chithigun23/ANUFS-BSPD-2026/docs/bspd-architecture.html

# ANUFS / BSPD 2026

Analog safety architecture · two fault paths, one latched shutdown

⏸ pause

### Sense + decide

- • TPS = throttle position; BPS = brake pressure.
- • Three independent sensor windows detect out-of-range inputs.
- • U1 detects hard braking with either throttle channel above 10%.

### Qualify + remember

- • Sensor faults: approximately 100 ms.
- • Brake/throttle overlap: approximately 1 second.
- • A sustained fault clears U5 Q; recovery alone does not re-enable.

### Power + reset

- • U6 regulates +12 V to +5 V for the logic.
- • U7 with R32/C19/C20 generates the power-on preset.
- • U5 drives Q1/Q2 and the latch LED; SC_OUT feeds the external shutdown circuit.

Connectivity: supplied KiCad netlist, 15 Sep 2026. Timing: schematic intent. Moving dots show logical propagation, not timing or current. Power, reference and indicator wiring summarized in the cards.
