chithigun23/ANUFS-BSPD-2026/BSPD_DigiKey_BOM.xlsx

Sheet: BOM
# | Reference(s) | Qty | Value | Package / Footprint | Manufacturer | Manufacturer Part Number (MPN) | DigiKey Part Number | Purchasing spec / action | Notes
1 | C1,C19,C20 | 3 | 4.7uF | C_0805_2012Metric_Pad1.18x1.45mm_HandSolder |  |  |  | Voltage: 16V; Dielectric: X7R; Tolerance: 10%; Existing BOM: TIMING CAP - X7R, 25V or 50V rating (NOT 6.3/10V); Select exact supplier part matching value and footprint. | Sets BSP-02 startup delay (C19||C20) and the 1 s trip timer (C1). Low-voltage-rated X7R loses 30-50% capacitance under 5 V DC bias, which shifts both timings. Order 25 V+ to minimise derating, then measure.
2 | C2-C7 | 6 | 1uF | C_0805_2012Metric_Pad1.18x1.45mm_HandSolder |  |  |  | Voltage: 16V; Dielectric: X7R; Tolerance: 10%; Existing BOM: X7R, 16V+; Select exact supplier part matching value and footprint. | Comparator input filters.
3 | C8-C14,C17,C18,C21-C28 | 17 | 100nF | C_0805_2012Metric_Pad1.18x1.45mm_HandSolder |  |  |  | Voltage: 16V; Dielectric: X7R; Tolerance: 10%; Existing BOM: X7R, 25V/50V; Select exact supplier part matching value and footprint. | Decoupling. Any reputable 0805 X7R.
4 | C15 | 1 | 10uF | C_0805_2012Metric_Pad1.18x1.45mm_HandSolder |  |  |  | Schematic: 25V, X7R, 10%. Select matching 0805 supplier part. | Input capacitor. Existing BOM specifies at least 25V.
5 | C16 | 1 | 10uF | C_0805_2012Metric_Pad1.18x1.45mm_HandSolder |  |  |  | Schematic: 16V, X7R, 10%. Resolve output-capacitor ESR requirement before ordering. | Existing BOM flags LM1117 output capacitor ESR. See Cautions.
6 | D1,D6 | 2 | 1N4148W | D_SOD-123 | Diodes Incorporated | 1N4148W-7-F |  | Match package and ordering suffix. | MPN inferred from value - verify before ordering.
7 | D2-D4 | 3 | AQ1005-01ETG | D_SOD-882 | Littelfuse | AQ1005-01ETG |  | Match package and ordering suffix.
8 | D5 | 1 | SMBJ16A | SMBJ16A | Littelfuse | SMBJ16A |  | Match package and ordering suffix. | LCSC: C151254
9 | D7,D8 | 2 | S1B-13-F | S1B-13-F | Diodes Incorporated | S1B-13-F |  | Match package and ordering suffix. | LCSC: C156295
10 | D9-D15 | 7 | AP2012EC | AP2012EC | Kingbright | AP2012EC |  | Match package and ordering suffix.
11 | J1 | 1 | Conn_02x04_Counter_Clockwise | WirePad_2x04_P3.0mm |  |  |  | No part to buy | Bare through-hole wire pads - solder wires directly. Bare wire pads.
12 | Q1 | 1 | AO3400A | SOT-23 | Alpha & Omega | AO3400A |  | Match package and ordering suffix. | MPN inferred from value - verify before ordering.
13 | Q2 | 1 | AO3401A | SOT-23 | Alpha & Omega | AO3401A |  | Match package and ordering suffix. | MPN inferred from value - verify before ordering.
14 | R1,R10,R15,R25 | 4 | 5.49k | R_0805_2012Metric_Pad1.20x1.40mm_HandSolder |  |  |  | Tolerance: 1%; Existing BOM: 0805, 1% (E96 value); Select exact supplier part matching value and footprint.
15 | R2,R4,R5,R9,R13,R17,R24 | 7 | 5.1k | R_0805_2012Metric_Pad1.20x1.40mm_HandSolder |  |  |  | Tolerance: 1%; Existing BOM: 0805, 1% (E96 value); Select exact supplier part matching value and footprint.
16 | R3,R6-R8,R11,R12,R14,R16,R18,R19,R22,R27,R32,R33 | 14 | 150k | R_0805_2012Metric_Pad1.20x1.40mm_HandSolder |  |  |  | Tolerance: 1%; Existing BOM: 0805, 1% (E96 value); Select exact supplier part matching value and footprint.
17 | R20,R30 | 2 | 54.9k | R_0805_2012Metric_Pad1.20x1.40mm_HandSolder |  |  |  | Tolerance: 1%; Existing BOM: 0805, 1% (E96 value); Select exact supplier part matching value and footprint.
18 | R21 | 1 | 21.5k | R_0805_2012Metric_Pad1.20x1.40mm_HandSolder |  |  |  | Tolerance: 1%; Existing BOM: 0805, 1% (E96 value); Select exact supplier part matching value and footprint.
19 | R23 | 1 | 2.61k | R_0805_2012Metric_Pad1.20x1.40mm_HandSolder |  |  |  | Tolerance: 1%; Existing BOM: 0805, 1% (E96 value); Select exact supplier part matching value and footprint.
20 | R26 | 1 | 7.15k | R_0805_2012Metric_Pad1.20x1.40mm_HandSolder |  |  |  | Tolerance: 1%; Existing BOM: 0805, 1% (E96 value); Select exact supplier part matching value and footprint.
21 | R28,R29 | 2 | 49.9k | R_0805_2012Metric_Pad1.20x1.40mm_HandSolder |  |  |  | Tolerance: 1%; Existing BOM: 0805, 1% (E96 value); Select exact supplier part matching value and footprint.
22 | R31,R39-R45 | 8 | 500 | R_0805_2012Metric_Pad1.20x1.40mm_HandSolder |  |  |  | Tolerance: 1%; Existing BOM: ORDER 499 ohm (E96 1%) or 510 ohm (E24 5%); Select exact supplier part matching value and footprint. | "500 ohm" is not a standard 1% value. These are LED series resistors (R39-R45) and R31 gate resistor - exact value is not critical.
23 | R34-R38 | 5 | 10M | R_0805_2012Metric_Pad1.20x1.40mm_HandSolder |  |  |  | Tolerance: 1%; Existing BOM: 1% - high value, check availability; Select exact supplier part matching value and footprint. | Threshold-node bleed resistors.
24 | R46 | 1 | 0 | R_0805_2012Metric_Pad1.20x1.40mm_HandSolder |  |  |  | Select exact supplier part matching value and footprint.
25 | RV1-RV5 | 5 | 3313J-1-203E | 3313J-1-103E | Bourns | 3313J-1-203E |  | Tolerance: 20%; Resistance: 20k | LCSC: C124621
26 | SW1,SW2 | 2 | CJS-1200TB1 | CJS-1200TB1 | Nidec Components | CJS-1200TB1 |  | Match package and ordering suffix. | LCSC: C2921631
27 | TP1 | 1 | TPS1 | TestPoint_Keystone_5000-5004_Miniature |  |  |  | Existing BOM: Optional - only if you want physical test pins; Optional physical test point; select matching footprint. | Keystone 5000-5004 miniature test point. Board works without them (bare pad).
28 | TP2 | 1 | TPS2 | TestPoint_Keystone_5000-5004_Miniature |  |  |  | Existing BOM: Optional - only if you want physical test pins; Optional physical test point; select matching footprint. | Keystone 5000-5004 miniature test point. Board works without them (bare pad).
29 | TP3 | 1 | BPS | TestPoint_Keystone_5000-5004_Miniature |  |  |  | Existing BOM: Optional - only if you want physical test pins; Optional physical test point; select matching footprint. | Keystone 5000-5004 miniature test point. Board works without them (bare pad).
30 | TP4 | 1 | +0V45 | TestPoint_Keystone_5000-5004_Miniature |  |  |  | Existing BOM: Optional - only if you want physical test pins; Optional physical test point; select matching footprint. | Keystone 5000-5004 miniature test point. Board works without them (bare pad).
31 | TP5 | 1 | +1V25 | TestPoint_Keystone_5000-5004_Miniature |  |  |  | Existing BOM: Optional - only if you want physical test pins; Optional physical test point; select matching footprint. | Keystone 5000-5004 miniature test point. Board works without them (bare pad).
32 | TP6 | 1 | +2V5 | TestPoint_Keystone_5000-5004_Miniature |  |  |  | Existing BOM: Optional - only if you want physical test pins; Optional physical test point; select matching footprint. | Keystone 5000-5004 miniature test point. Board works without them (bare pad).
33 | TP7 | 1 | +4V5 | TestPoint_Keystone_5000-5004_Miniature |  |  |  | Existing BOM: Optional - only if you want physical test pins; Optional physical test point; select matching footprint. | Keystone 5000-5004 miniature test point. Board works without them (bare pad).
34 | U1-U4 | 4 | TLV1704AIPWR | TLV1704 | Texas Instruments | TLV1704AIPWR |  | Match package and ordering suffix.
35 | U5 | 1 | SN74HC74DR | SN74HC74DR | Texas Instruments | SN74HC74DR |  | Match package and ordering suffix. | LCSC: C6762
36 | U6 | 1 | LM1117MP-5.0 | SOT-223-3_TabPin2 | Texas Instruments | LM1117MP-5.0/NOPB |  | Match package and ordering suffix. | MPN inferred from value - verify before ordering.
37 | U7 | 1 | SN74LVC2G14DBVR | SN74LVC2G14DBVR | Texas Instruments | SN74LVC2G14DBVR |  | Match package and ordering suffix. | LCSC: C12401
38 | U8,U9 | 2 | SN74LVC3G14DCUR | SN74LVC3G14DCUR | Texas Instruments | SN74LVC3G14DCUR |  | Match package and ordering suffix. | LCSC: C98856
 | TOTAL PLACEMENTS | 115

Sheet: Cautions
Item | Severity | What it is | What to do before / when ordering
BSP-04 C16 regulator output cap | HIGH | U6 (LM1117MP-5.0) output capacitor C16 is a generic 10uF in an 0805 footprint. TI's datasheet states the output cap ESR must be 0.3-22 ohm and specifies 10uF minimum IF A TANTALUM IS USED. A standard 0805 X5R/X7R MLCC has roughly 0.005 ohm ESR - 60x below TI's minimum - so the loop can oscillate. | The 0805 pads are the HandSolder type (elongated), so a 1206/3216 tantalum can usually be tacked across them. Order BOTH: a 10uF 25V X7R 0805 (default fit) AND a 10uF 16V tantalum (e.g. Kemet T491A/AVX TAJ A-case) as the fallback. At bring-up, scope the 5 V rail for oscillation; if it rings, fit the tantalum.
BSP-08 TVS vs regulator rating | HIGH | D5 is an SMBJ16A (16 V standoff) feeding U6 directly. Verified from TI's datasheet: LM1117 absolute max VIN = 20 V, recommended max = 15 V. The SMBJ16A clamps to 26.0 V at its full rated 23.1 A pulse - above the regulator's absolute maximum. Protection coordination is unproven for a large surge. | No board change possible at this revision. Mitigate off-board: make sure there is real series impedance upstream (fuse + harness length) so the TVS never has to clamp at full rated current at the regulator's pins. Treat 'survives supply transients' as a bench item. For v2, consider a 40 V-capable regulator.
Timing-cap DC bias (affects BSP-02 / BSP-05) | MEDIUM | C1 sets the ~1 s trip timer (R7+R8 = 300k into C1 = 4.7uF -> 0.977 s) and C19||C20 = 9.4uF sets the startup preset delay with R32 = 150k. Class-II ceramics (X5R/X7R) lose large amounts of capacitance under DC bias - a 6.3 V or 10 V rated 4.7uF 0805 can drop 30-50% at 5 V, shortening BOTH timings. | Order the 4.7uF parts at 25 V or 50 V rating in 0805 - higher voltage rating means far less derating at 5 V. Then measure both timings on the bench (BSP-05 already accepts the margin, so the measurement is the closing evidence).
R31, R39-R45 '500 ohm' | LOW | The schematic value is 500 ohm, which is not a standard E96 (1%) or E24 (5%) value. | Order 499 ohm (E96 1%) or 510 ohm (E24 5%). These are LED series resistors and one gate resistor - the exact value is not critical.
TP7 silkscreen label | LOW (cosmetic, but permanent) | TP7 connects to net +4V7 (the divider produces ~4.75 V) but its silkscreen label reads '+4V5'. Once the PCB is fabricated this is permanent. | If you have not sent the PCB yet, change TP7's value/label to +4V7. Otherwise just note it - the test point is electrically correct, only the label is wrong.
Silkscreen text height | LOW (cosmetic) | Seven silkscreen labels (BPS, FLT, TP1, HB, TPx10, LATCH, TP2) are 0.9 mm; JLCPCB's stated minimum legible silk text height is 1.0 mm. | JLCPCB will still print them, just less crisply. Bump to 1.0 mm if you are doing another layout pass anyway.
BSP-03 Threshold calibration | OPEN - not a board change | The adjustable thresholds (RV1-RV5, SW1/SW2) cannot be set correctly without measured sensor characteristics from the actual car. | Confirm the throttle-body and brake-pressure sensor part numbers, measure their endpoints, then set and secure the trimmers. This is commissioning work, not a fab blocker.
BSP-01 Sensor-loss timing | OPEN - engineering note only | Retained as an engineering note; the review records no mandatory PCB change. | Optional characterisation if your validation plan includes the sensor-loss case.
Supplier selection | TO COMPLETE | Rows without an exact MPN require part selection. | Use the value, footprint and listed specifications. Blank DigiKey numbers have not been sourced.
DigiKey Upload | SCOPE | Only explicit schematic MPNs and non-inferred existing BOM MPNs are included. | Resolve rows with missing or inferred part numbers on the BOM before adding them to an order.
Quantity basis | INFO | 115 BOM-included board items; one board. | Excludes: G***, G***, G***, H1, H2, H3, H4. Optional test points and bare wire pads may not require purchased parts.
Source | INFO | Current bspd.kicad_pcb and matching schematic, 2026-09-15. | Quantities and footprints use the PCB. Part metadata uses the schematic.
Capacitor voltage specifications | CHECK | The schematic uses 16V for timing/decoupling capacitors; the existing BOM recommends higher ratings. | Both source specifications are retained on the BOM. Resolve the purchasing rating before ordering.

Sheet: DigiKey Upload
Manufacturer Part Number | Quantity | Customer Reference
AQ1005-01ETG | 3 | D2-D4
SMBJ16A | 1 | D5
S1B-13-F | 2 | D7,D8
AP2012EC | 7 | D9-D15
3313J-1-203E | 5 | RV1-RV5
CJS-1200TB1 | 2 | SW1,SW2
TLV1704AIPWR | 4 | U1-U4
SN74HC74DR | 1 | U5
SN74LVC2G14DBVR | 1 | U7
SN74LVC3G14DCUR | 2 | U8,U9
Only source-specified MPNs are listed. Complete missing or inferred part numbers on the BOM before ordering.
