chithigun23/ANUFS-BSPD-2026/bspd-kicad/bspd-library/3d/SN74AHC14DBR.step

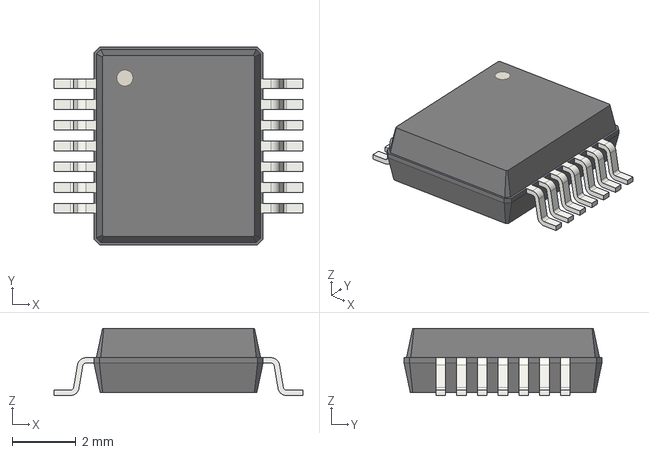
[picture p1: CAD file, 2026-09-29]
bspd-kicad/bspd-library/3d/SN74AHC14DBR.step
7.80 x 6.20 x 2.10 mm
