chithigun23/ANUFS-BSPD-2026/bspd-kicad/bspd-library/3d/3313J-1-203E.step

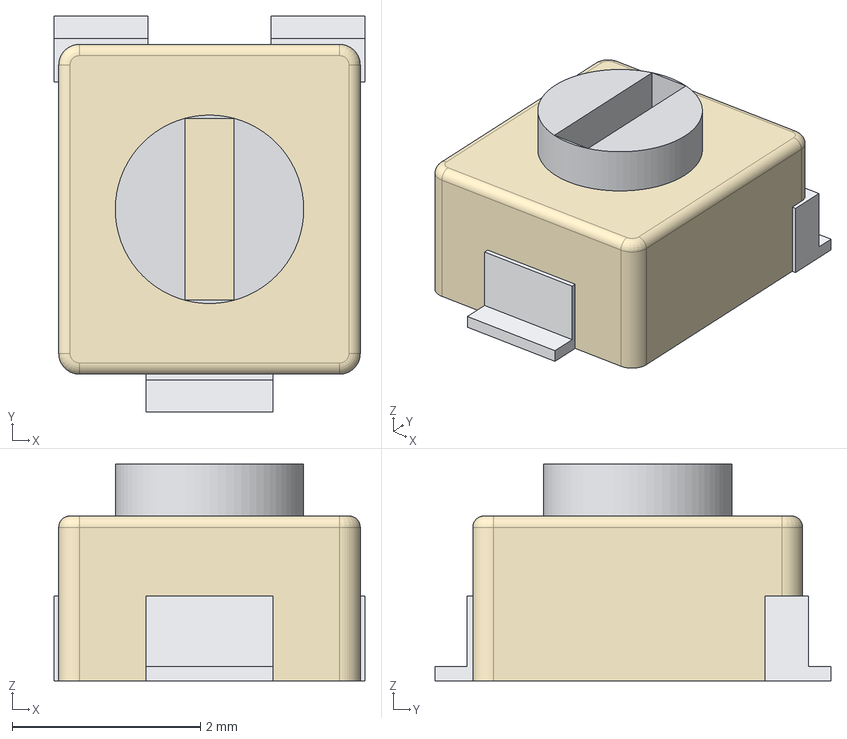
[picture p2: CAD file, 2026-09-15]
bspd-kicad/bspd-library/3d/3313J-1-203E.step
3.30 x 4.20 x 2.30 mm
housing
rotor
pin1
pin2
pin3
