chithigun23/ANUFS-BSPD-2026/bspd-kicad/bspd-library/3d/MOLEX_430450600.stp

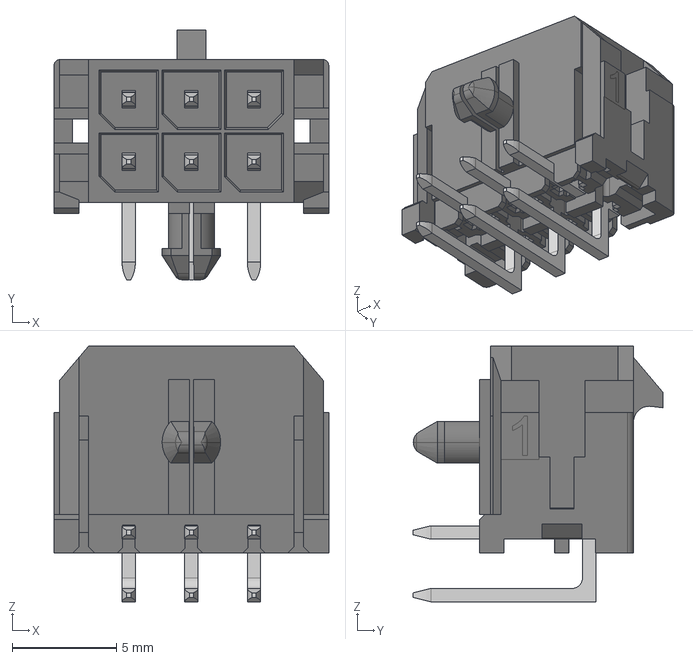
[picture p3: CAD file, 2026-09-04]
bspd-kicad/bspd-library/3d/MOLEX_430450600.stp
13.2 x 12.0 x 12.2 mm
