chithigun23/ANUFS-BSPD-2026/bspd-kicad/bspd-library/3d/MOLEX_430450800.stp

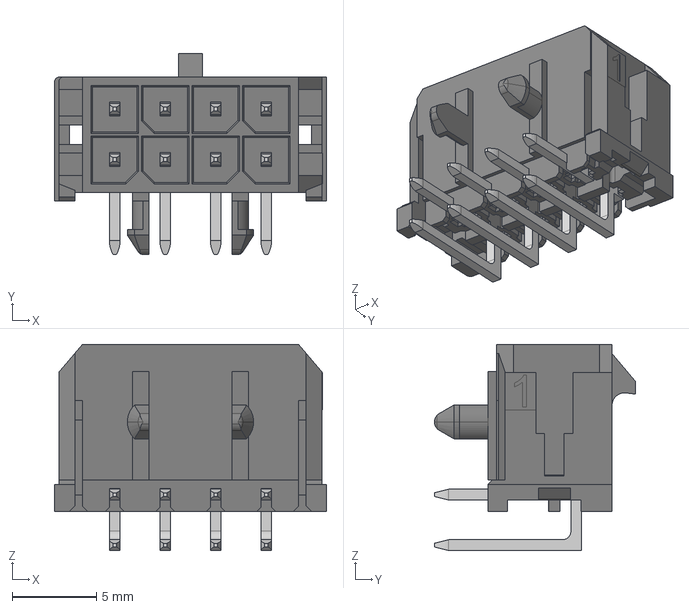
[picture p4: CAD file, 2026-09-04]
bspd-kicad/bspd-library/3d/MOLEX_430450800.stp
16.2 x 12.0 x 12.2 mm
