chithigun23/ANUFS-BSPD-2026/bspd-kicad/bspd-library/3d/DT13-6P.step

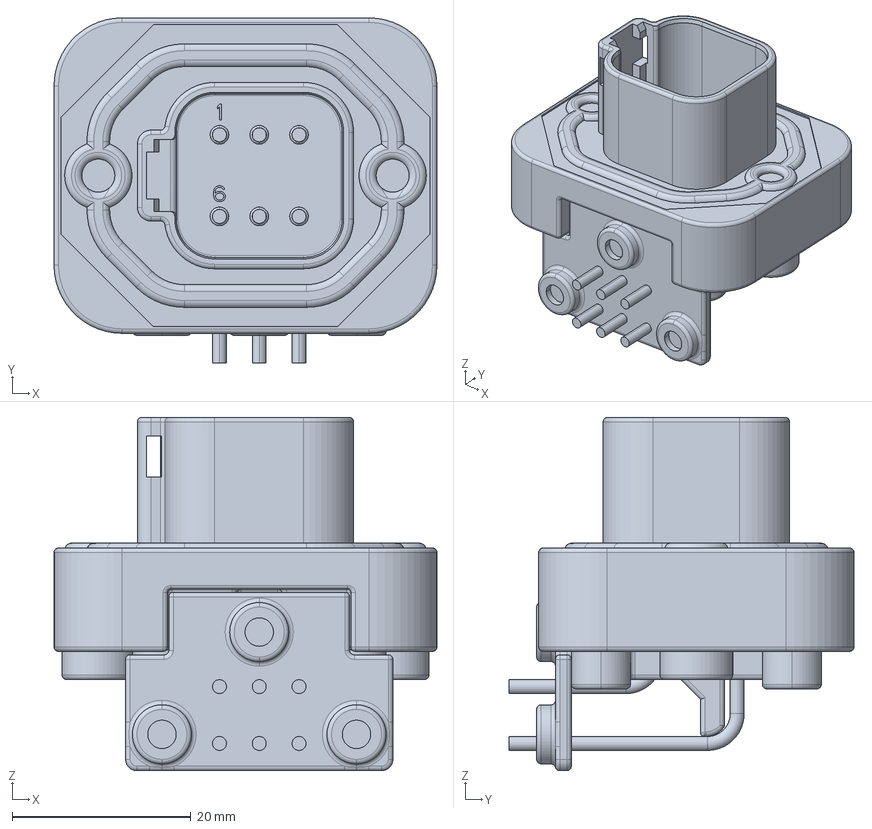
[picture p5: CAD file, 2026-09-04]
bspd-kicad/bspd-library/3d/DT13-6P.step
42.8 x 38.6 x 39.5 mm
