chithigun23/ANUFS-BSPD-2026/bspd-kicad/bspd-library/3d/S1B-13-F.step

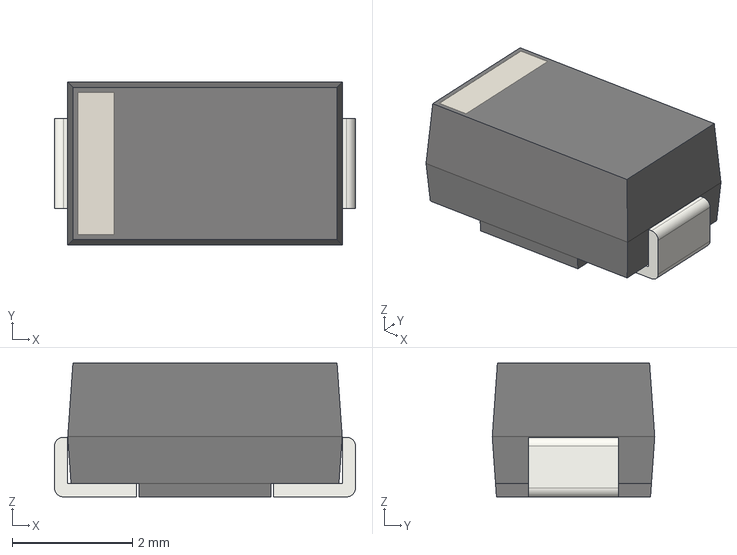
[picture p6: CAD file, 2026-09-04]
bspd-kicad/bspd-library/3d/S1B-13-F.step
5.00 x 2.70 x 2.22 mm
