chithigun23/ANUFS-BSPD-2026/bspd-kicad/bspd-library/3d/CJS-1200TB1.step

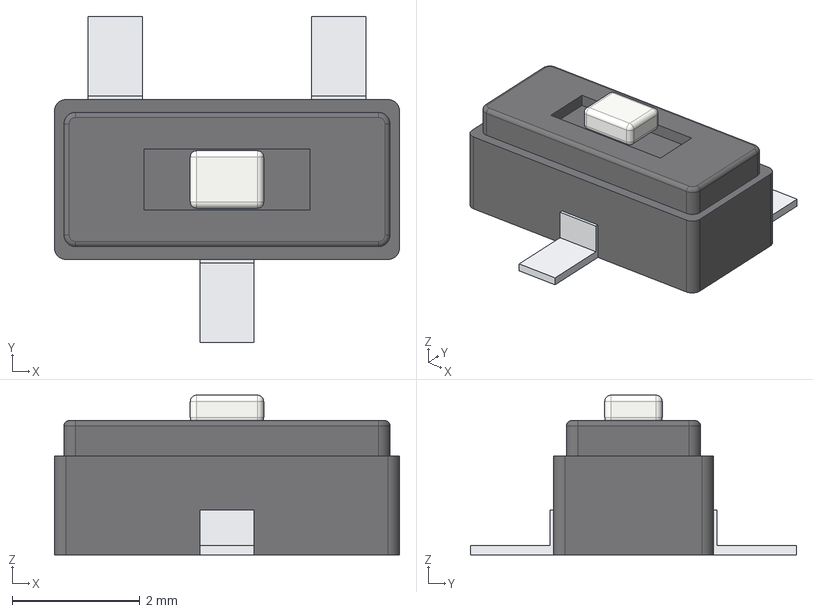
[picture p7: CAD file, 2026-09-03]
bspd-kicad/bspd-library/3d/CJS-1200TB1.step
5.40 x 5.10 x 2.50 mm
housing
knob
pin1
pin2
pin3
