chithigun23/ANUFS-BSPD-2026/bspd-kicad/bspd-library/3d/219-2LPST.step

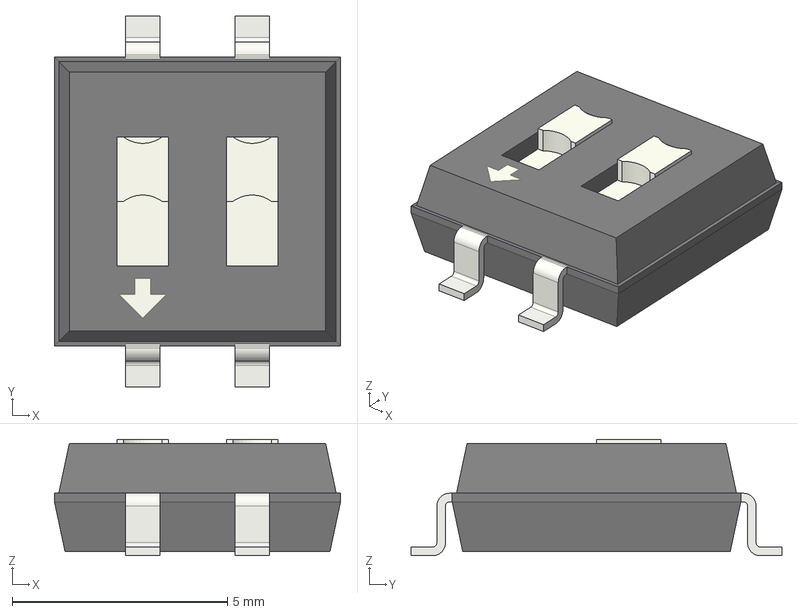
[picture p8: CAD file, 2026-08-30]
bspd-kicad/bspd-library/3d/219-2LPST.step
6.64 x 8.61 x 2.70 mm
