chithigun23/ANUFS-BSPD-2026/bspd-kicad/bspd-library/3d/219-4MST.step

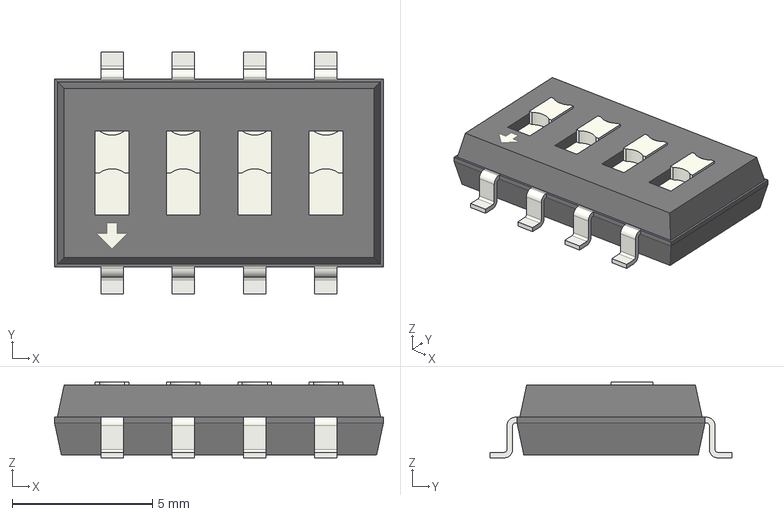
[picture p9: CAD file, 2026-08-30]
bspd-kicad/bspd-library/3d/219-4MST.step
11.7 x 8.61 x 2.70 mm
