chithigun23/ANUFS-BSPD-2026/bspd-kicad/bspd-library/3d/SMBJ16A.step

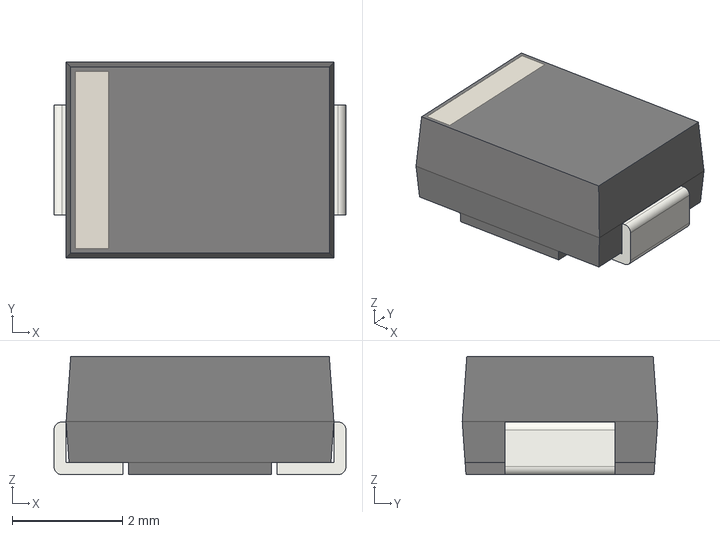
[picture p10: CAD file, 2026-08-30]
bspd-kicad/bspd-library/3d/SMBJ16A.step
5.30 x 3.55 x 2.15 mm
