chithigun23/ANUFS-BSPD-2026/bspd-kicad/bspd-library/3d/AP2012EC.step

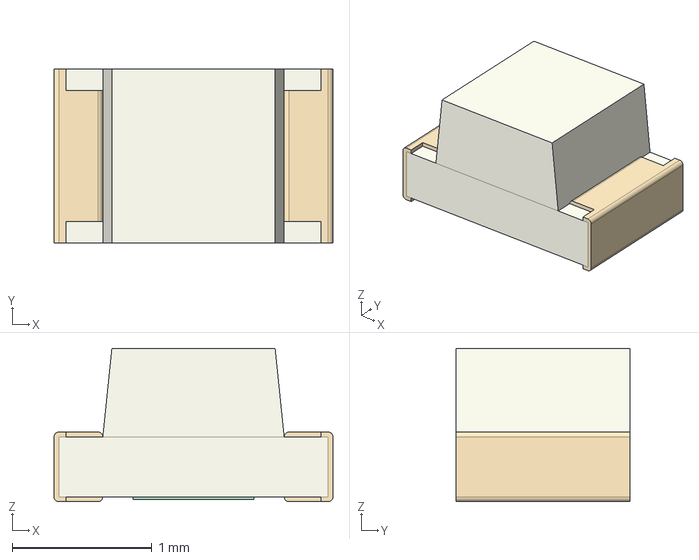
[picture p11: CAD file, 2026-08-30]
bspd-kicad/bspd-library/3d/AP2012EC.step
2.00 x 1.25 x 1.10 mm
