chithigun23/ANUFS-BSPD-2026/bspd-kicad/bspd-library/3d/SN74LVC2G14DBVR.step

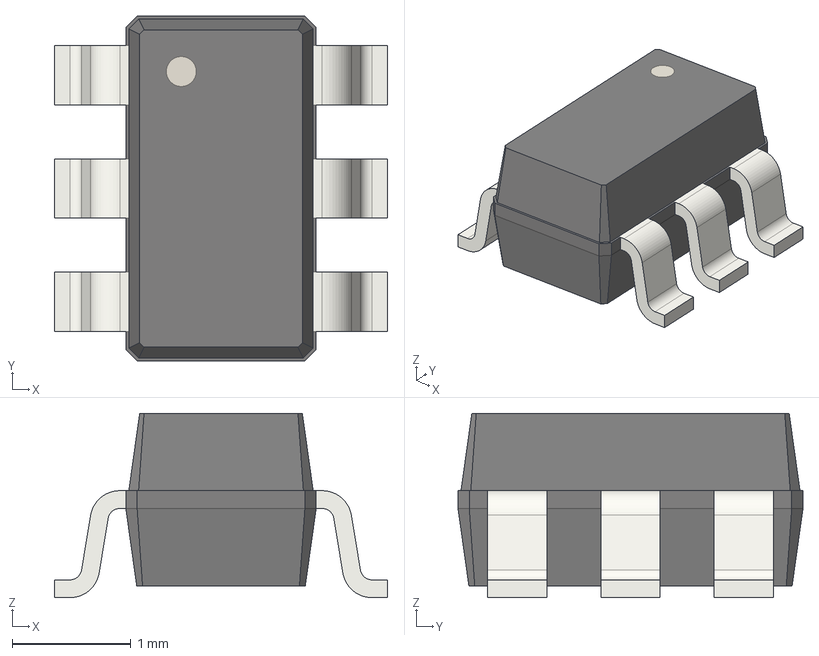
[picture p12: CAD file, 2026-08-30]
bspd-kicad/bspd-library/3d/SN74LVC2G14DBVR.step
2.80 x 2.90 x 1.55 mm
