chithigun23/ANUFS-BSPD-2026/bspd-kicad/bspd-library/3d/SN74HC74DR.step

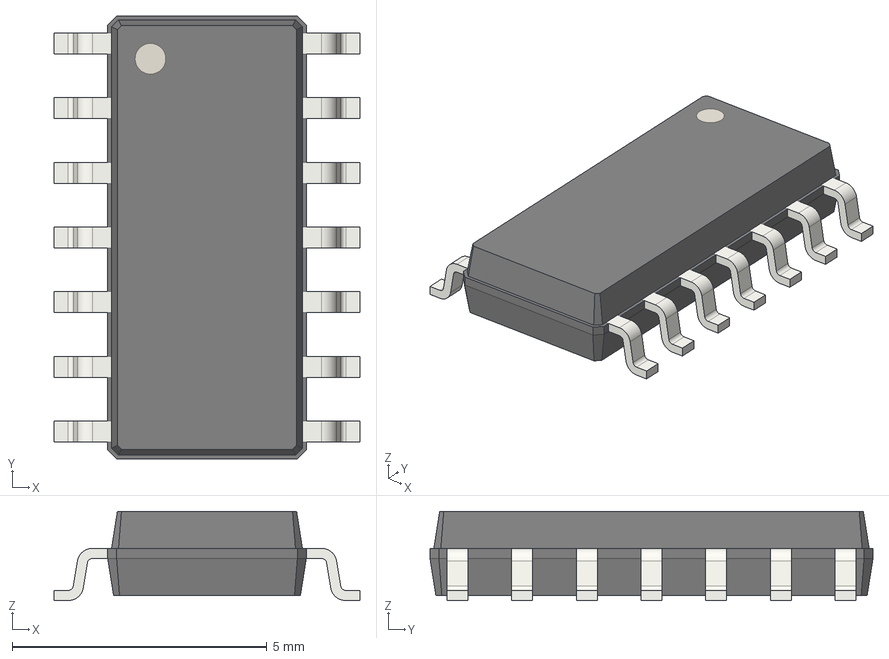
[picture p13: CAD file, 2026-08-30]
bspd-kicad/bspd-library/3d/SN74HC74DR.step
6.00 x 8.70 x 1.75 mm
