chithigun23/ANUFS-BSPD-2026/bspd-kicad/bspd-library/3d/MCP1703T-5002E-CB.step

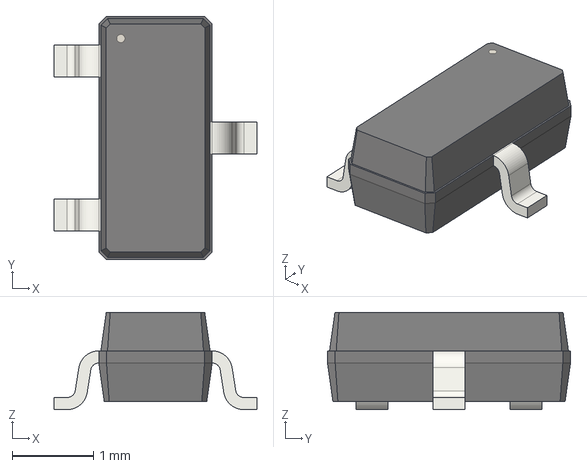
[picture p14: CAD file, 2026-08-28]
bspd-kicad/bspd-library/3d/MCP1703T-5002E-CB.step
2.50 x 3.00 x 1.20 mm
