chithigun23/ANUFS-BSPD-2026/bspd-kicad/bspd-library/3d/SN74LVC3G14DCUR.step

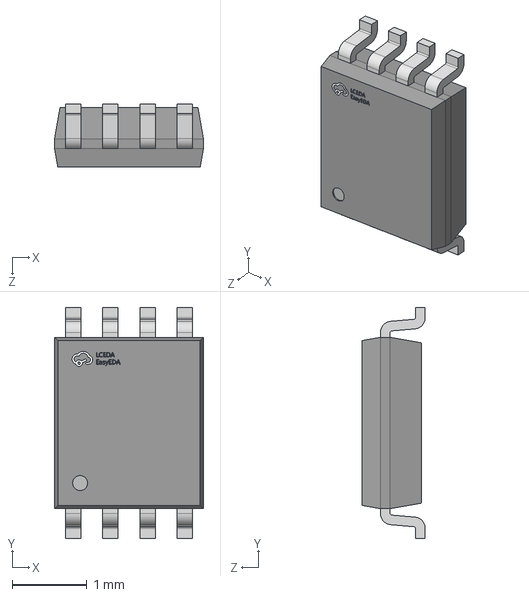
[picture p15: CAD file, 2026-08-28]
bspd-kicad/bspd-library/3d/SN74LVC3G14DCUR.step
2.00 x 3.10 x 0.851 mm
