chithigun23/ANUFS-BSPD-2026/bspd-kicad/bspd-library/3d/SN74LVC2G00DCTR.step

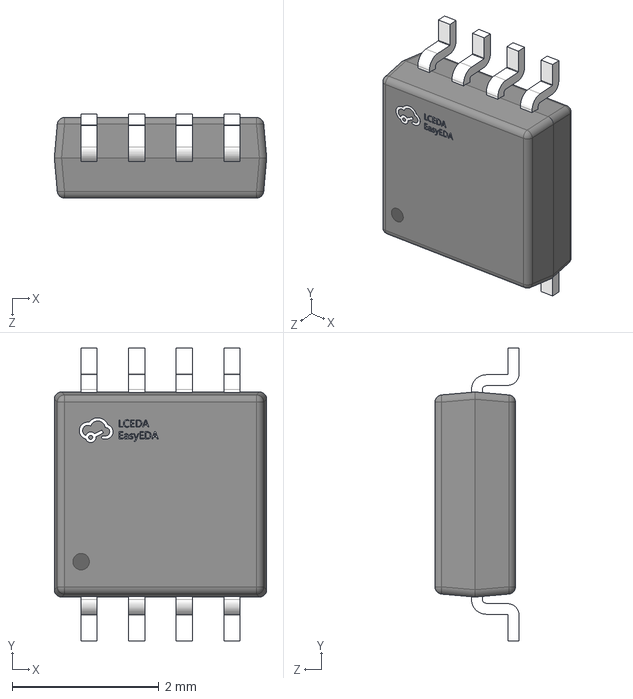
[picture p16: CAD file, 2026-08-28]
bspd-kicad/bspd-library/3d/SN74LVC2G00DCTR.step
2.90 x 4.00 x 1.15 mm
