chithigun23/ANUFS-BSPD-2026/bspd-kicad/bspd-library/3d/TLV1704.step

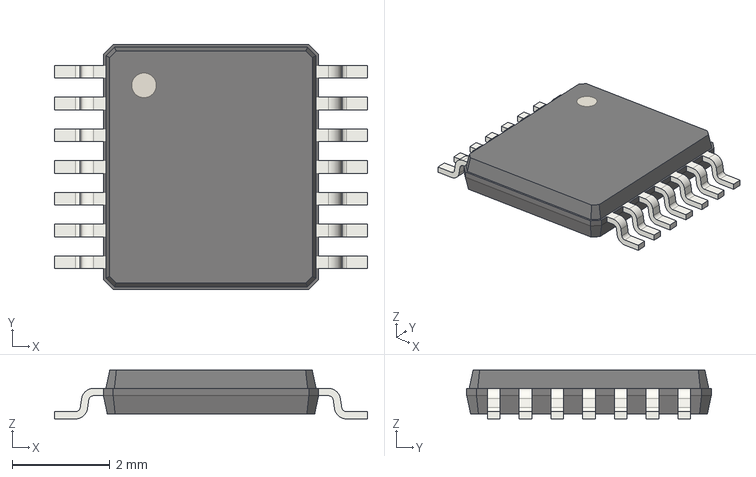
[picture p17: CAD file, 2026-08-28]
bspd-kicad/bspd-library/3d/TLV1704.step
6.40 x 5.00 x 1.00 mm
