chithigun23/ANUFS-BSPD-2026/bspd-kicad/bspd-library/3d/TLV3202AQDGKRQ1.stp

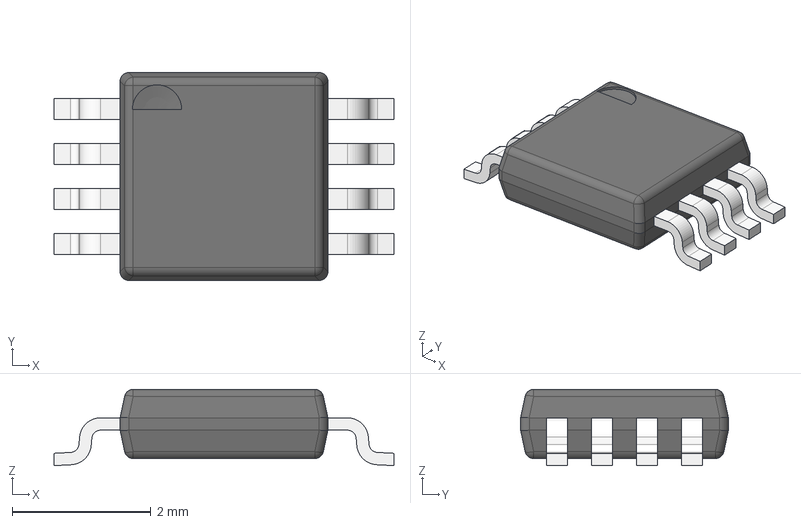
[picture p18: CAD file, 2026-08-09]
bspd-kicad/bspd-library/3d/TLV3202AQDGKRQ1.stp
4.90 x 3.00 x 1.10 mm
BODY_MUA08A
LEAD_MUA08A x 8
