chithigun23/ANUFS-BSPD-2026/(list of files, cad)

Other CAD files:
bspd-kicad/bspd-library/3d/3313J-1-103E.step
