chithigun23/ANUFS-BSPD-2026/bspd-kicad/bspd.kicad_pcb

## KiCad design bspd-kicad/bspd.kicad_pcb (2026-09-29)

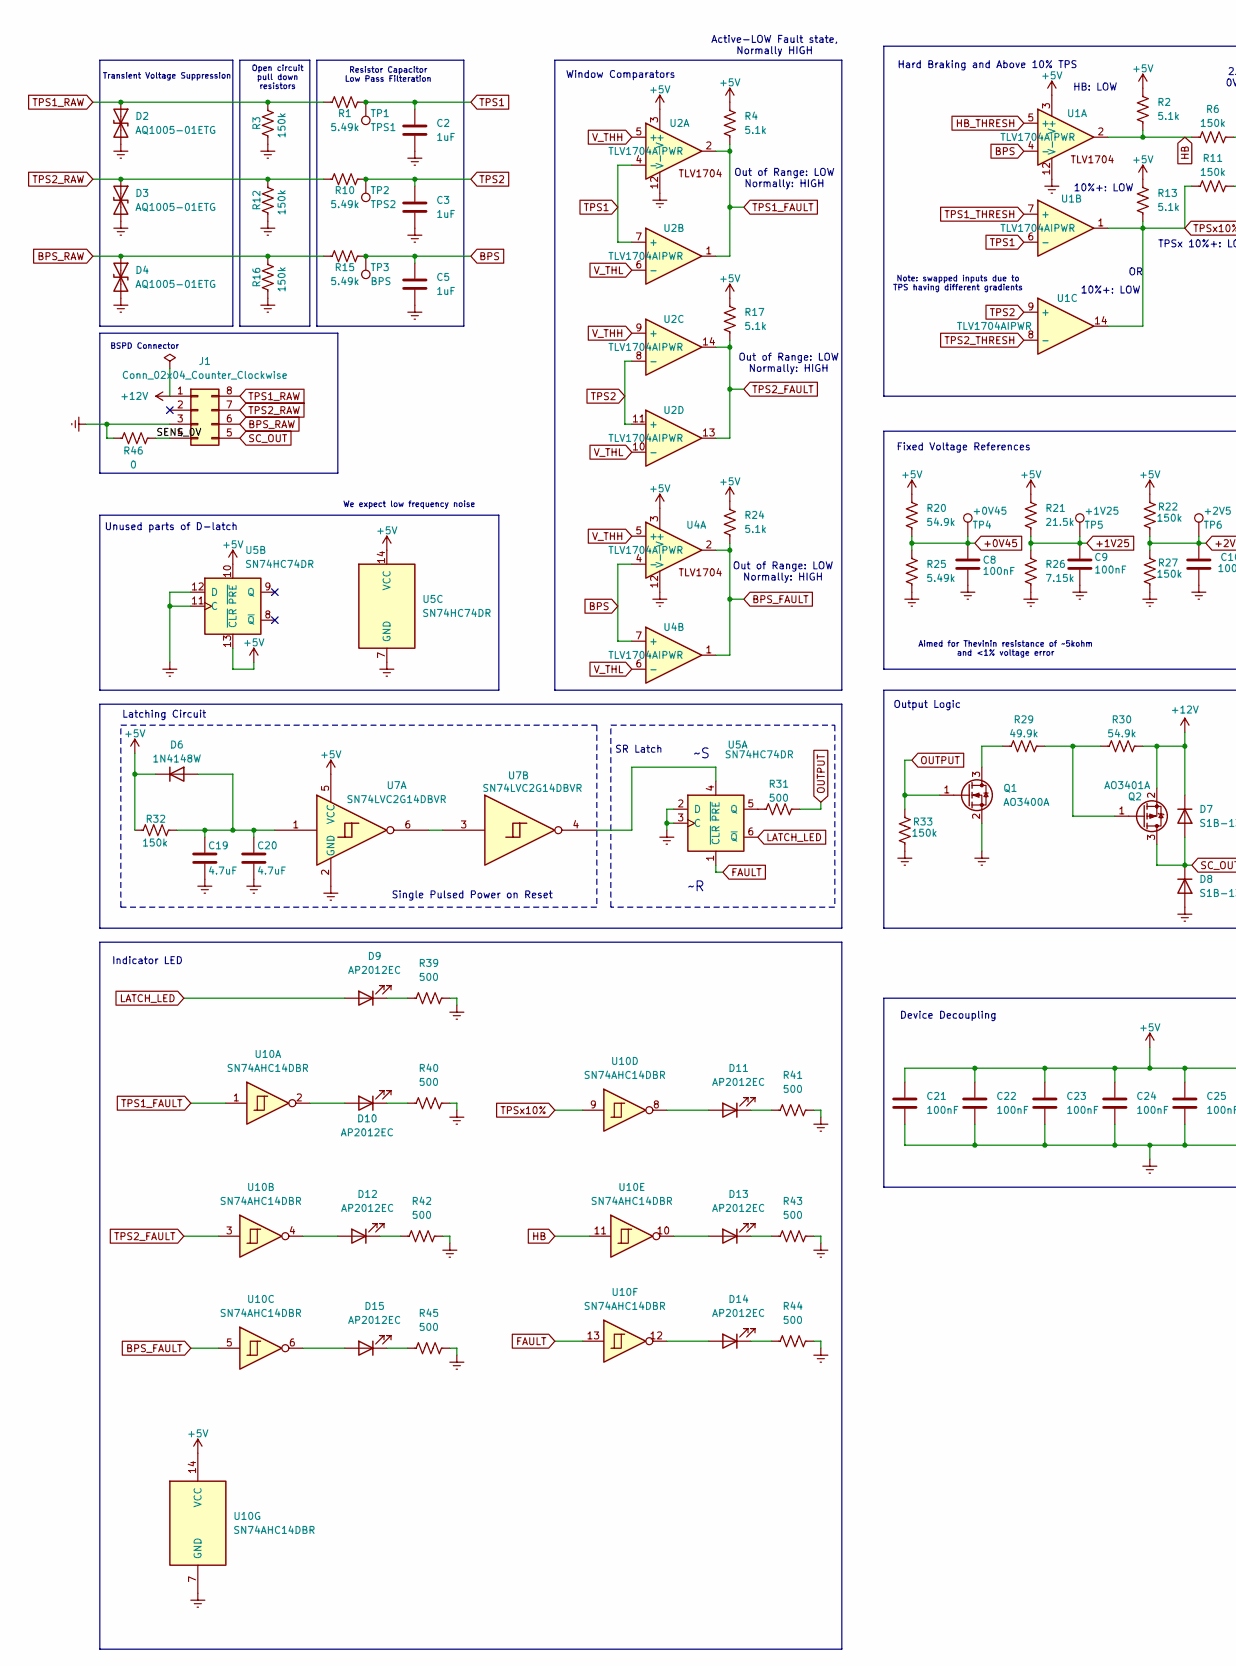
[picture p19: schematic bspd.kicad_sch, part in row 1, column 1]

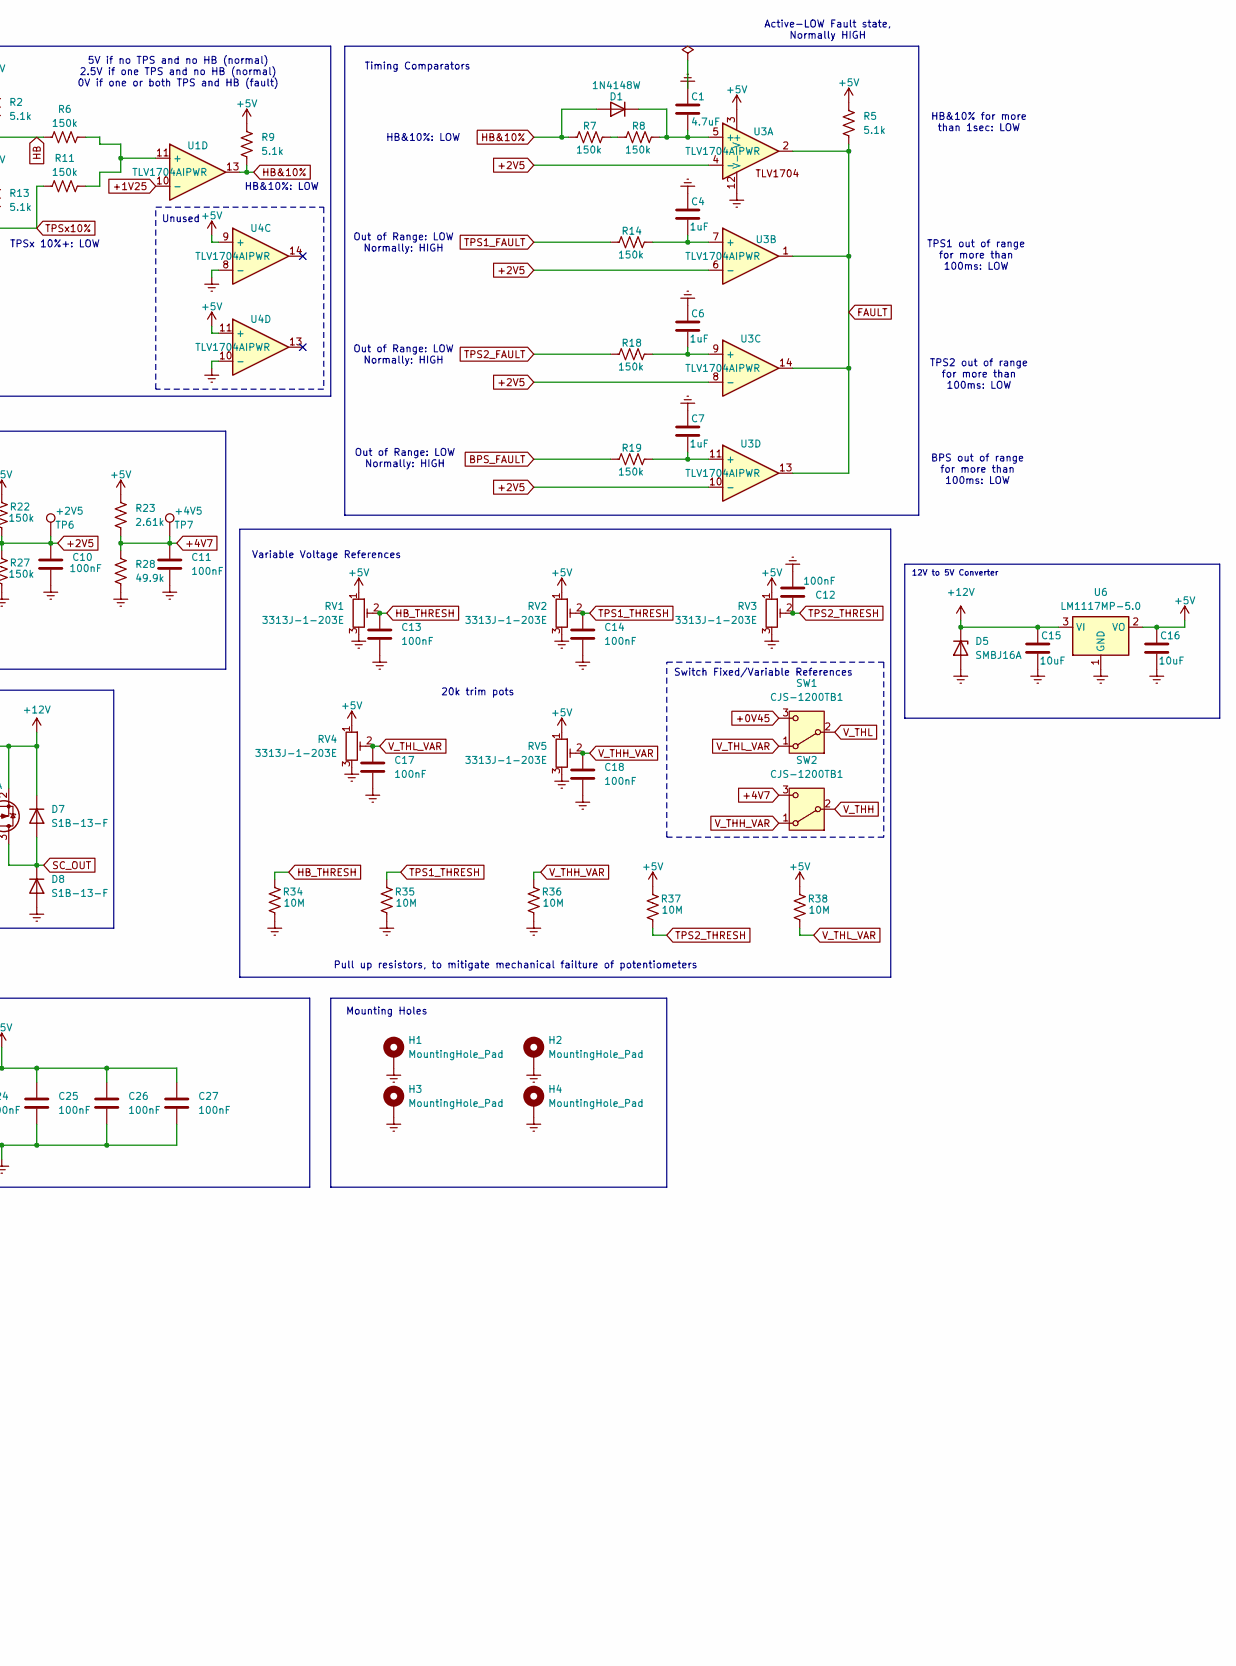
[picture p20: schematic bspd.kicad_sch, part in row 1, column 2]

Parts:
C1, C19, C20: 4.7uF; C_0805_2012Metric_Pad1.18x1.45mm_HandSolder; Voltage 16V; Tolerance 10%
C2, C3, C4, C5, C6, C7: 1uF; C_0805_2012Metric_Pad1.18x1.45mm_HandSolder; Voltage 16V; Tolerance 10%
C8, C9, C10, C11, C12, C13, C14, C17, C18, C21, C22, C23, C24, C25, C26, C27: 100nF; C_0805_2012Metric_Pad1.18x1.45mm_HandSolder; Voltage 16V; Tolerance 10%
C15: 10uF; C_0805_2012Metric_Pad1.18x1.45mm_HandSolder; Voltage 25V; Tolerance 10%
C16: 10uF; C_0805_2012Metric_Pad1.18x1.45mm_HandSolder; Voltage 16V; Tolerance 10%
D1, D6: 1N4148W; D_SOD-123
D2, D3, D4: AQ1005-01ETG; D_SOD-882; MPN AQ1005-01ETG
D5: SMBJ16A; MPN SMBJ16A; LCSC Part C151254
D7, D8: S1B-13-F; MPN S1B-13-F; LCSC Part C156295
D9, D10, D11, D12, D13, D14, D15: AP2012EC; MPN AP2012EC
H1, H2, H3, H4: MountingHole_Pad; MountingHole_3.2mm_M3_ISO14580_Pad
J1: Conn_02x04_Counter_Clockwise; WirePad_2x04_P3.0mm
Q1: AO3400A; SOT-23
Q2: AO3401A; SOT-23
R1, R10, R15, R25: 5.49k; R_0805_2012Metric_Pad1.20x1.40mm_HandSolder; Tolerance 1%
R2, R4, R5, R9, R13, R17, R24: 5.1k; R_0805_2012Metric_Pad1.20x1.40mm_HandSolder; Tolerance 1%
R3, R6, R7, R8, R11, R12, R14, R16, R18, R19, R22, R27, R32, R33: 150k; R_0805_2012Metric_Pad1.20x1.40mm_HandSolder; Tolerance 1%
R20, R30: 54.9k; R_0805_2012Metric_Pad1.20x1.40mm_HandSolder; Tolerance 1%
R21: 21.5k; R_0805_2012Metric_Pad1.20x1.40mm_HandSolder; Tolerance 1%
R23: 2.61k; R_0805_2012Metric_Pad1.20x1.40mm_HandSolder; Tolerance 1%
R26: 7.15k; R_0805_2012Metric_Pad1.20x1.40mm_HandSolder; Tolerance 1%
R28, R29: 49.9k; R_0805_2012Metric_Pad1.20x1.40mm_HandSolder; Tolerance 1%
R31, R39, R40, R41, R42, R43, R44, R45: 500; R_0805_2012Metric_Pad1.20x1.40mm_HandSolder; Tolerance 1%
R34, R35, R36, R37, R38: 10M; R_0805_2012Metric_Pad1.20x1.40mm_HandSolder; Tolerance 1%
R46: 0; R_0805_2012Metric_Pad1.20x1.40mm_HandSolder
RV1, RV2, RV3, RV4, RV5: 3313J-1-203E; Tolerance 20%; MPN 3313J-1-203E; LCSC Part C124621
SW1, SW2: CJS-1200TB1; MPN CJS-1200TB1; LCSC Part C2921631
TP1: TPS1; TestPoint_Keystone_5000-5004_Miniature
TP2: TPS2; TestPoint_Keystone_5000-5004_Miniature
TP3: BPS; TestPoint_Keystone_5000-5004_Miniature
TP4: +0V45; TestPoint_Keystone_5000-5004_Miniature
TP5: +1V25; TestPoint_Keystone_5000-5004_Miniature
TP6: +2V5; TestPoint_Keystone_5000-5004_Miniature
TP7: +4V5; TestPoint_Keystone_5000-5004_Miniature
U1, U2, U3, U4: TLV1704AIPWR; TLV1704; MPN TLV1704AIPWR
U5: SN74HC74DR; MPN SN74HC74DR; LCSC Part C6762
U6: LM1117MP-5.0; SOT-223-3_TabPin2
U7: SN74LVC2G14DBVR; MPN SN74LVC2G14DBVR; LCSC Part C12401
U10: SN74AHC14DBR

Connections:
+0V45: C8.1, R20.2, R25.1, SW1.3 (C), TP4.1 (1_1)
+1V25: C9.1, R21.2, R26.1, TP5.1 (1_1), U1.10 (-)
+2V5: C10.1, R22.1, R27.2, TP6.1 (1_1), U3.4 (-), U3.6 (-), U3.8 (-), U3.10 (-)
+4V7: C11.1, R23.2, R28.1, SW2.3 (C), TP7.1 (1_1)
+5V: C16.2, C21.1, C22.1, C23.1, C24.1, C25.1, C26.1, C27.1, D6.1 (K), R2.1, R4.1, R5.1, R9.1, R13.1, R17.1, R20.1, R21.1, R22.2, R23.1, R24.1, R32.1, R37.2, R38.2, RV1.1, RV2.1, RV3.1, RV4.1, RV5.1, U1.3 (V+), U2.3 (V+), U3.3 (V+), U4.3 (V+), U4.9 (+), U4.11 (+), U5.10 (~PRE), U5.13 (~CLR), U5.14 (VCC), U6.2 (VO), U7.5 (VCC), U10.14 (VCC)
+12V: C15.2, D5.1 (K), D7.1 (K), J1.1, Q2.2 (S), R30.1, U6.3 (VI)
/SENS_0V: J1.4, R46.2
BPS: C5.1, R15.2, TP3.1 (1_1), U1.4 (-), U4.4 (-), U4.7 (+)
BPS_FAULT: R19.1, R24.2, U4.1, U4.2, U10.5
BPS_RAW: D4.1 (A1), J1.6, R15.1, R16.2
FAULT: R5.2, U3.1, U3.2, U3.13, U3.14, U5.1 (~CLR), U10.13
GND: C1.2, C2.2, C3.2, C4.2, C5.2, C6.2, C7.2, C8.2, C9.2, C10.2, C11.2, C12.2, C13.2, C14.2, C15.1, C16.1, C17.2, C18.2, C19.1, C20.1, C21.2, C22.2, C23.2, C24.2, C25.2, C26.2, C27.2, D2.2 (A2), D3.2 (A2), D4.2 (A2), D5.2 (A), D8.2 (A), H1.1 (1_1), H2.1 (1_1), H3.1 (1_1), H4.1 (1_1), J1.3, Q1.2 (S), R3.1, R12.1, R16.1, R25.2, R26.2, R27.1, R28.2, R33.1, R34.1, R35.1, R36.1, R39.2, R40.2, R41.2, R42.2, R43.2, R44.2, R45.2, R46.1, RV1.3, RV2.3, RV3.3, RV4.3, RV5.3, U1.12 (V-), U2.12 (V-), U3.12 (V-), U4.8 (-), U4.10 (-), U4.12 (V-), U5.2 (D), U5.3 (C), U5.7 (GND), U5.11 (C), U5.12 (D), U6.1 (GND), U7.2 (GND), U10.7 (GND)
HB: R2.2, R6.2, U1.2, U10.11
HB&10%: D1.2 (A), R7.1, R9.2, U1.13
HB_THRESH: C13.1, R34.2, RV1.2, U1.5 (+)
LATCH_LED: D9.2 (A), U5.6 (~Q)
unnamed: C1.1, D1.1 (K), R8.2, U3.5 (+)
unnamed: C19.2, C20.2, D6.2 (A), R32.2, U7.1
unnamed: D9.1 (K), R39.1
unnamed: D10.2 (A), U10.2
unnamed: D10.1 (K), R40.1
unnamed: D11.2 (A), U10.8
unnamed: D11.1 (K), R41.1
unnamed: D12.2 (A), U10.4
unnamed: D12.1 (K), R42.1
unnamed: D13.2 (A), U10.10
unnamed: D13.1 (K), R43.1
unnamed: D14.2 (A), U10.12
unnamed: D14.1 (K), R44.1
unnamed: D15.2 (A), U10.6
unnamed: D15.1 (K), R45.1
unnamed: Q1.3 (D), R29.1
unnamed: Q2.1 (G), R29.2, R30.2
unnamed: R7.2, R8.1
unnamed: R6.1, R11.1, U1.11 (+)
unnamed: C4.1, R14.2, U3.7 (+)
unnamed: C6.1, R18.2, U3.9 (+)
unnamed: C7.1, R19.2, U3.11 (+)
unnamed: R31.1, U5.5 (Q)
unnamed: U5.4 (~PRE), U7.4
unnamed: U7.3, U7.6
OUTPUT: Q1.1 (G), R31.2, R33.2
SC_OUT: D7.2 (A), D8.1 (K), J1.5, Q2.3 (D)
TPS1: C2.1, R1.2, TP1.1 (1_1), U1.6 (-), U2.4 (-), U2.7 (+)
TPS1_FAULT: R4.2, R14.1, U2.1, U2.2, U10.1
TPS1_RAW: D2.1 (A1), J1.8, R1.1, R3.2
TPS1_THRESH: C14.1, R35.2, RV2.2, U1.7 (+)
TPS2: C3.1, R10.2, TP2.1 (1_1), U1.9 (+), U2.8 (-), U2.11 (+)
TPS2_FAULT: R17.2, R18.1, U2.13, U2.14, U10.3
TPS2_RAW: D3.1 (A1), J1.7, R10.1, R12.2
TPS2_THRESH: C12.1, R37.1, RV3.2, U1.8 (-)
TPSx10%: R11.2, R13.2, U1.1, U1.14, U10.9
V_THH: SW2.2 (B), U2.5 (+), U2.9 (+), U4.5 (+)
V_THH_VAR: C18.1, R36.2, RV5.2, SW2.1 (A)
V_THL: SW1.2 (B), U2.6 (-), U2.10 (-), U4.6 (-)
V_THL_VAR: C17.1, R38.1, RV4.2, SW1.1 (A)

Notes on the sheet:
HB&10%: LOW
Single Pulsed Power on Reset
Unused parts of D-latch
Mounting Holes
Variable Voltage References
Note: swapped inputs due to TPS having different gradients
Out of Range: LOW Normally: HIGH
Resistor Capacitor Low Pass Filteration
Output Logic
Switch Fixed/Variable References
Indicator LED
Fixed Voltage References
Window Comparators
Aimed for Thevinin resistance of ~5kohm and <1% voltage error
Device Decoupling
Latching Circuit
SR Latch
HB: LOW
TPS1 out of range for more than 100ms: LOW
10%+: LOW
TPSx 10%+: LOW
We expect low frequency noise
Timing Comparators
BSPD Connector
HB&10% for more than 1sec: LOW
Active-LOW Fault state, Normally HIGH
20k trim pots
Pull up resistors, to mitigate mechanical failture of potentiometers
Open circuit pull down resistors
BPS out of range for more than 100ms: LOW
12V to 5V Converter
Hard Braking and Above 10% TPS
Unused
TPS2 out of range for more than 100ms: LOW
Transient Voltage Suppression
5V if no TPS and no HB (normal) 2.5V if one TPS and no HB (normal) 0V if one or both TPS and HB (fault)

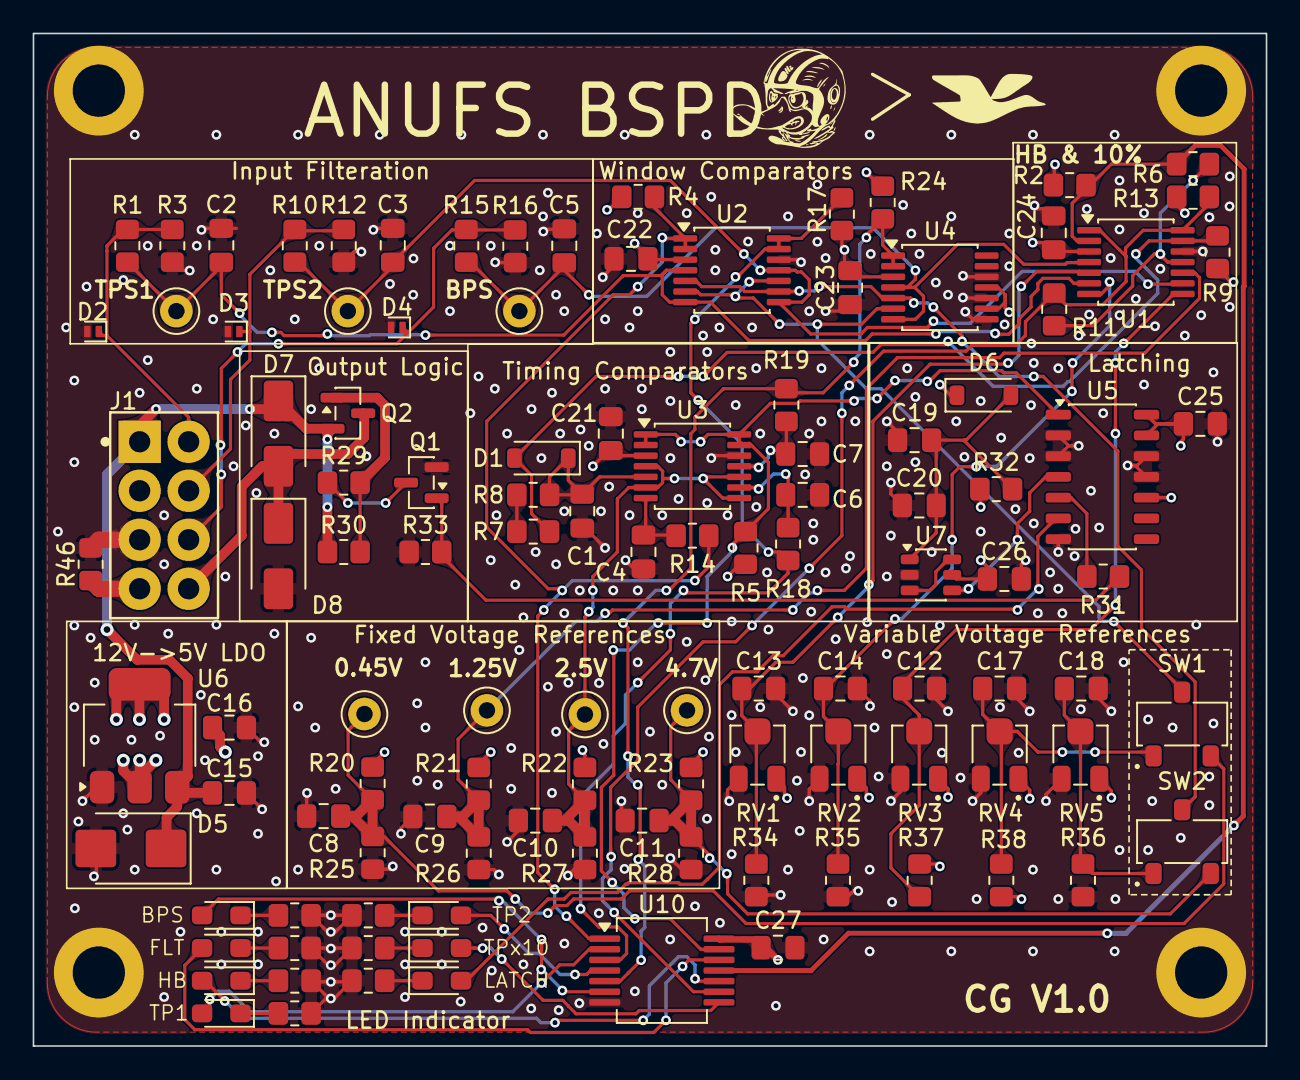
[picture p21: board bspd.kicad_pcb from above]

Board: 4 copper layers, 75.5 x 62.0 mm, 117 parts (0 on the bottom side), 56 nets.
