chithigun23/ANUFS-BSPD-2026/(commit log)

2026-08-09 Chosen a push-pull comparitor, automotive grade and rail-to-rail. Requirecreating logic and timing circuits. I believe the old version used incorrect circuit design with respect to open drain output 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
    [TLV3202AQDGKRQ1.stp, bspd.kicad_pcb, bspd.kicad_sch]
2026-08-28 Decided on TLV1704, working on HB and TP>10% logic
    [bspd.kicad_sch]
2026-08-28 Completed timing
    [bspd.kicad_sch]
2026-08-28 Added fixed references
    [bspd.kicad_sch]
2026-08-28 Latching circuit done
    [SN74LVC2G00DCTR.step, SN74LVC3G14DCUR.step, TLV1704.step, bspd.kicad_sch]
2026-08-28 fixed foot print, added power and connector
    [MCP1703T-5002E-CB.step, bspd.kicad_pcb, bspd.kicad_sch]
2026-08-28 Begun layout
    [bspd.kicad_pcb, bspd.kicad_sch]
2026-08-30 Switched to D latch chip
    [SN74HC74DR.step, SN74LVC2G14DBVR.step, bspd.kicad_pcb, bspd.kicad_sch]
2026-08-30 Fixed latch and added indicator LEDs
    [3313J-1-103E.step, AP2012EC.step, TLC59116IPWR.step, bspd.kicad_pcb, bspd.kicad_sch]
2026-08-30 Added decoupling
    [SMBJ16A.step, bspd.kicad_sch]
2026-08-30 TVS for 12V added
    [bspd.kicad_sch]
2026-08-30 Modified output logic
    [219-2LPST.step, 219-4MST.step, CJS-1200TB1.step, bspd.kicad_sch]
2026-09-03 Started layout, emphasis on looking good
    [3313J-1-103E.step, CJS-1200TB1.step, bspd.kicad_pcb, bspd.kicad_sch]
2026-09-03 Layout progress
    [bspd.kicad_pcb, bspd.kicad_sch]
2026-09-04 Draft complete
    [MOLEX_430450600.stp, bspd.kicad_pcb, bspd.kicad_sch]
2026-09-04 Added logos
    [bspd.kicad_pcb]
2026-09-05 Moved high current line closer to connector to minimise high current trace going accross the pcb
    [bspd.kicad_pcb]
2026-09-08 Footprint error, rerouting needed
    [bspd.kicad_pcb]
2026-09-08 all issues addressed
    [bspd.kicad_pcb, bspd.kicad_sch]
2026-09-08 Fixed library issue
    [AQ1005-01ETG.step, bspd.kicad_sch]
2026-09-08 Move GND earth symbol into project library; complete BOM fields
    [bspd.kicad_pcb, bspd.kicad_sch]
2026-09-08 ERC issues addressed
    [bspd.kicad_sch]
2026-09-10 Move bspd-library inside the project and make all paths relative
    The part library lived beside the project and was referenced by absolute
    Windows paths, so the project only worked from this one machine/location.
    - Move bspd-library/ into bspd-kicad/ (git mv, history preserved)
    - sym-lib-table / fp-lib-table: ${KIPRJMOD}/../bspd-library -> ${KIPRJMOD}/bspd-library
    - Convert all 43 hard-coded 3D model paths to ${KIPRJMOD}-relative:
    18 in bspd-library/footprint/*.kicad_mod, 25 embedded in bspd.kicad_pcb
    Only (model ...) lines changed in the PCB and footprints; no copper,
    pads or geometry touched. Verified after the move:
    - netlist SHA256 identical to pre-move baseline (60 nets, 118 compon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
    [219-2LPST.step, 219-4MST.step, 3313J-1-103E.step, AP2012EC.step, AQ1005-01ETG.step, CJS-1200TB1.step, DT13-6P.step, MCP1703T-5002E-CB.step]
2026-09-10 Signal ground and chassis ground connected with 0 ohm resistor
    [bspd.kicad_pcb, bspd.kicad_sch]
2026-09-14 clean up and BOM update
    [BSPD_DigiKey_BOM.xlsx]
2026-09-15 Fix mislabeled RV1-RV5 trimmer footprint and remove unused duplicate diode footprint
    The trimpot footprint was named/described as a 10k part when it's actually the 20k version used on the board; renamed it to match. Also removed a custom TVS diode footprint that was never used since D2-D4 already used KiCad's built-in equivalent footprint.
    [3313J-1-203E.step, AQ1005-01ETG.step, bspd.kicad_pcb, bspd.kicad_sch]
2026-09-25 Added TLV170x window comparator diagram
    [bspd-B_Cu.gbl, bspd-B_Mask.gbs, bspd-B_Silkscreen.gbo, bspd-Edge_Cuts.gm1, bspd-F_Cu.gtl, bspd-F_Mask.gts, bspd-F_Silkscreen.gto, bspd-NPTH.drl]
2026-09-29 Tidy schematic label, fix README heading, drop stale lock files
    - Move the TLV1704AIPWR value text (layout-only, no connectivity change)
    - README: "Attrobitom" heading corrected to "Attribution"
    - Remove committed KiCad lock files
    Verified 29 September 2026: ERC 0; zone-refilled DRC 0 violations,
    0 unconnected, 0 parity; netlist 119/119 parts; JLCPCB_gerbers/ match a
    fresh export.
    [bspd.kicad_sch]
2026-09-29 Add pad/via teardrops and regenerate JLCPCB gerbers
    - Teardrops on 587 track-to-pad/via junctions (same parameters as APPPD and
    Telemetry); teardrops enabled on every pad and via.
    - Tracks, vias, footprints and pours unchanged; zone-refilled DRC still
    0 violations, 0 unconnected, 0 parity; netlist 119/119 parts.
    - Gerbers regenerated; F.Cu/B.Cu carry the teardrops, inner planes differ
    only by a few refill vertices.
    [bspd-B_Cu.gbl, bspd-B_Mask.gbs, bspd-B_Silkscreen.gbo, bspd-Edge_Cuts.gm1, bspd-F_Cu.gtl, bspd-F_Mask.gts, bspd-F_Silkscreen.gto, bspd-NPTH.drl]
2026-09-29 Switched to hex inverter for indication LEDs
    [SN74AHC14DBR.step, bspd.kicad_pcb, bspd.kicad_sch]
