chithigun23/ANUFS-BSPD-2026/(notices)

Notices in the files:
bspd-kicad/bspd-library/3d/S1B-13-F.step:
Copyright (C) 2017, kicad StepUp
This program is free software: you can redistribute it and/or modify
it under the terms of the GNU General Public License as published by
the Free Software Foundation, either version 3 of the License, or
any later version.
itself might be covered by the GNU General Public License.
bspd-kicad/bspd-library/3d/AP2012EC.step:
Copyright (C) 2018, kicad StepUp
This work is licensed under the [Creative Commons CC-BY-SA 4.0 License](https://creativecommons.org/licenses/by-sa/4.0/legalcode),
with the following exception:
To the extent that the creation of electronic designs that use 'Licensed Material' can be considered to be 'Adapted Material',
You are free to use the library data in your own projects without the obligation to share your project files under this or any other license agreement.
bspd-kicad/bspd-library/3d/SN74LVC2G14DBVR.step:
Copyright (C) 2025, KiCAD
This work is licensed under the
[Creative Commons CC-BY-SA 4.0 License](https://creativecommons.org/licenses/by-sa/4.0/legalcode),
project files under this or any other license agreement. However, if you wish to distribute
bspd-kicad/bspd-library/3d/219-4MST.step:
Copyright (C) 2018, Terje Io
This work is licensed under the Creative Commons CC-BY-SA 4.0 License with the following exception:
To the extent that the creation of electronic designs that use 'Licensed Material'
https://creativecommons.org/licenses/by-sa/4.0/legalcode
